tamu-edu-students/ECEN403_Team49/Pics/Pics/rpi.jpg

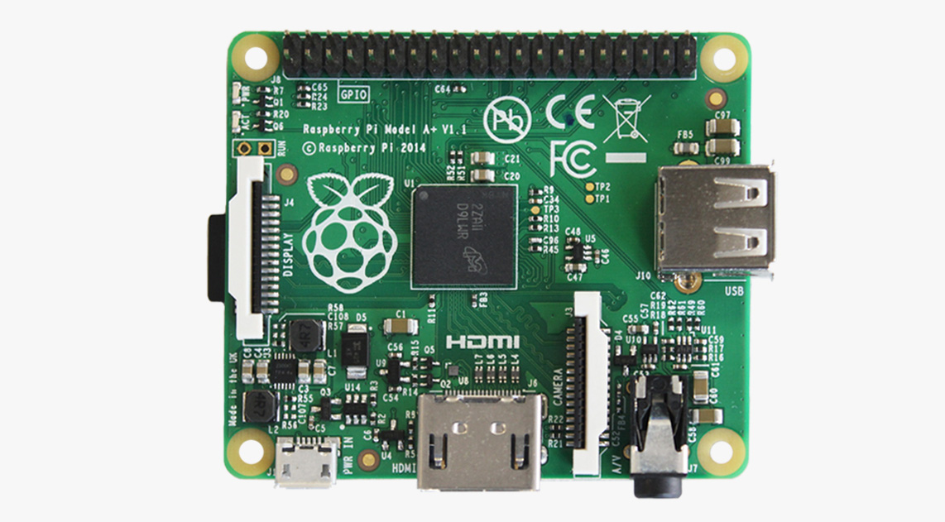
Pics/Pics/rpi.jpg
