tamu-edu-students/ECEN403_Team49/Pics/Pics/fan.PNG

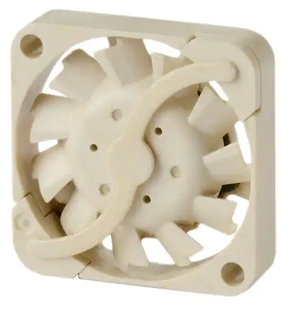
Pics/Pics/fan.PNG
