tamu-edu-students/ECEN403_Team49/README.md

# ECEN403_Team49
ECEN 403 - Team 49: Creating STEM Contents: Solar Power with a Tracking System
