tamu-edu-students/ECEN403_Team49/FinalReport.docx

Creating STEM Contents: Solar Power with a Tracking System

Leo Predanic

George Thuita

Brandon Cenci

Final Report

REVISION – Final

29 April 2023

Table of Contents

Concepts of Operations 1

Functional System Requirements 12

Interface Control Document 29

Execution and Validation 40

Subsystems Report 46

Integration Report 86

Calibrated LWIR Raw Video Data Collection - Gold Standard – Test 1 Revision -
