tamu-edu-students/ECEN403_Team49/Pics/Pics/report_pres_images.pptx

Solar Radiation

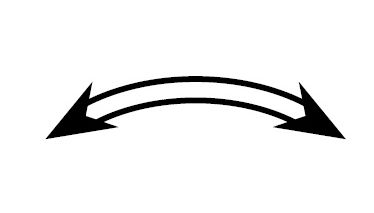
[picture p79: figure]

180° Zenith Angle

Voltage/Current Sense

PCB

Charge Controller

Battery

DC-DC Converter

Switches

Load

GUI & Database


User Interaction

Solar Panel

ADC

MCU

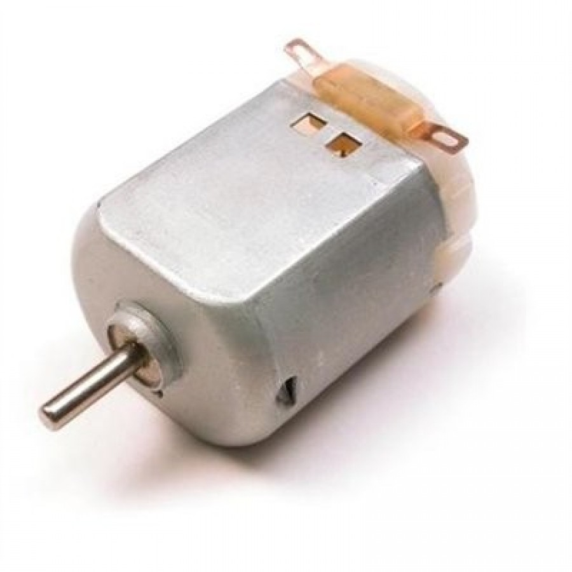
[picture p80: figure]

Motor

Minimum Desk Boundary

## Slide 2

GUI & Database

User Interaction

Voltage/Current Sense

PCB

Charge Controller

Battery

DC-DC Converter

Switches

Load

Solar Panel

ADC

MCU

Motor

Minimum Desk Boundary

## Slide 3

ADC

MCU

Motor

Solar Panel

5.5V
100mA

Charge Controller

3.7V

Battery

2.5V - 3.7V

Buck Boost Converter

3.0V
200mA

Load
