tamu-edu-students/ECEN403_Team49/404 Status Update #4 Team 49.pptx

## ECEN 404 Creating STEM Contents: Solar Power with a Tracking System Status Update #4 Leo Predanic George Thuita Brandon Cenci Sponsor: Dr. Won Jang TA: Souryendu Das


## Executive Summary

Problem statement:
- To create the future of tomorrow, we must invest today - by getting students interested in STEM early
Our Solution:
- Excite K-12 students by creating a portable solar system for demonstration purposes
- Contain digestible figures & animations to describe/track system


## System Flow & Overview


## Execution

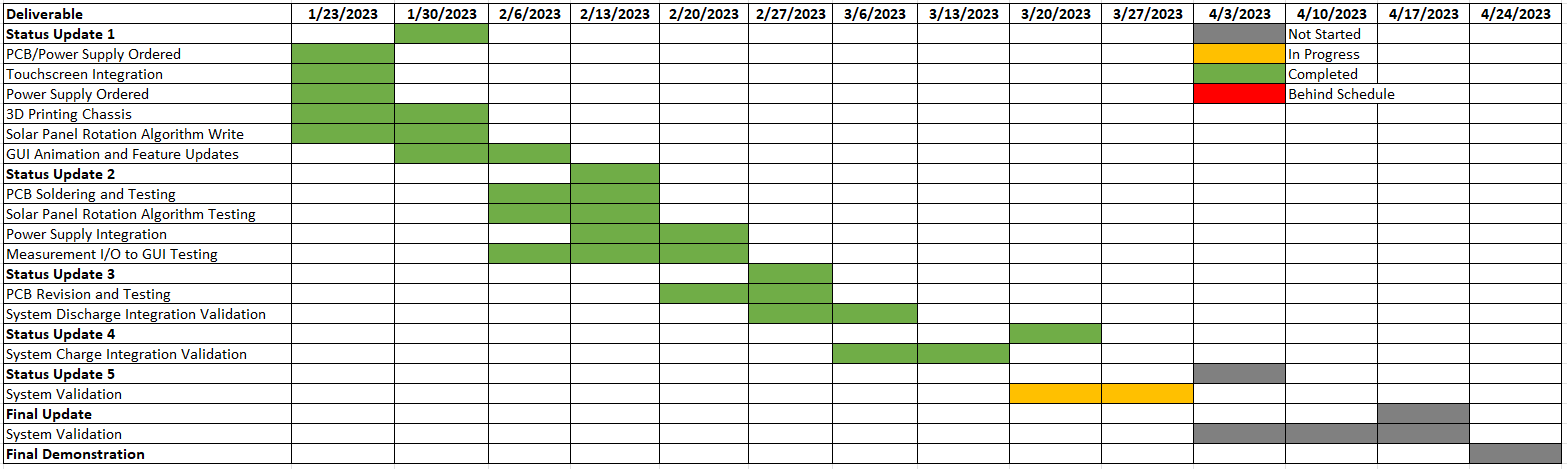
[picture p130: figure]

## Validation

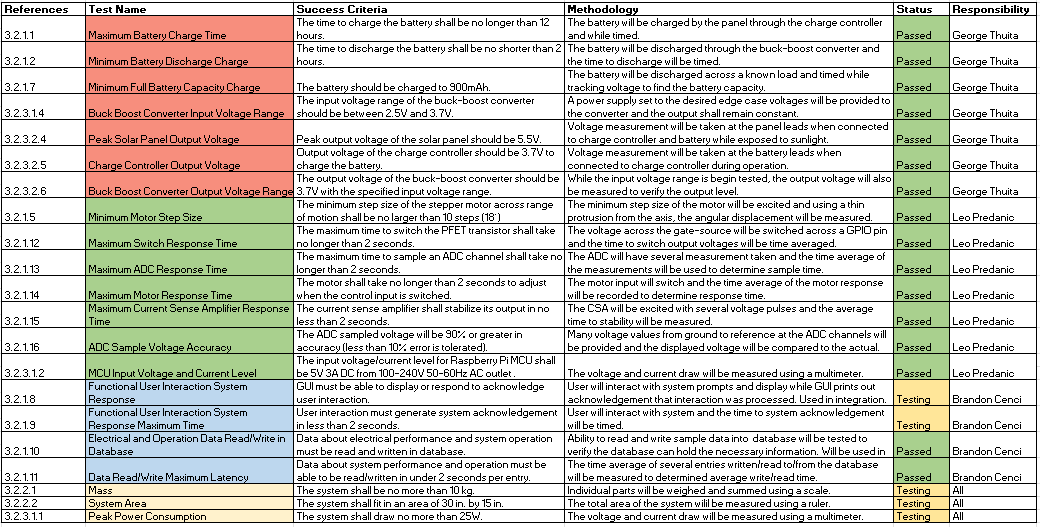
[picture p131: figure]

## Slide 6

Integrated System George Thuita/Leo Predanic/Brandon Cenci

Accomplishments since last presentation 20 hrs each | Ongoing progress/problems and plans until next presentation
-Solar charging issues fixed -System can now solar charge (additional wired charging feature) -Validation on charge side operation -GUI updates and finalization -User control of motor and solar charging mode rotation algorithm -Validation of graphing from internal database -Addition of failsafes to ensure proper user operation | -Solar panel chassis adjustments -Preliminary complete system test -Final validation marks -Additional improvements

## Slide 7

Integrated System (2) George Thuita/Leo Predanic/Brandon Cenci


Discharge Against Time Test Load
Roughly Constant Current across Battery Voltage


Wired Charge Time: ~1 hr (Full Overcharge - 4.2V)
Solar Charge Time: 8-9 hrs (Nominal Voltage - 3.7V)
Discharge Time: ~2.5 hrs (System Load)
Capacity: ~880mAh (Full Overcharge)

## Slide 8

Integrated System (3) George Thuita/Leo Predanic/Brandon Cenci

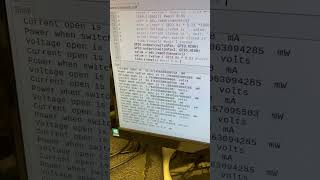
[picture p132: figure]

Solar Panel Integration Test

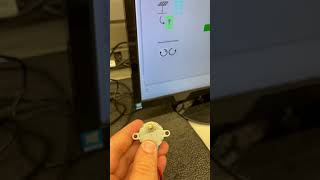
[picture p133: figure]

Motor Manual Control

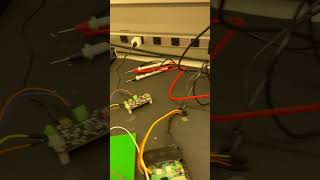
[picture p134: figure]

Charge Controller Integration test

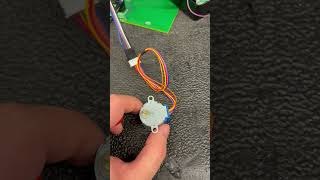
[picture p135: figure]

Motor Timed Control

## Slide 9

Integrated System (4) George Thuita/Leo Predanic/Brandon Cenci

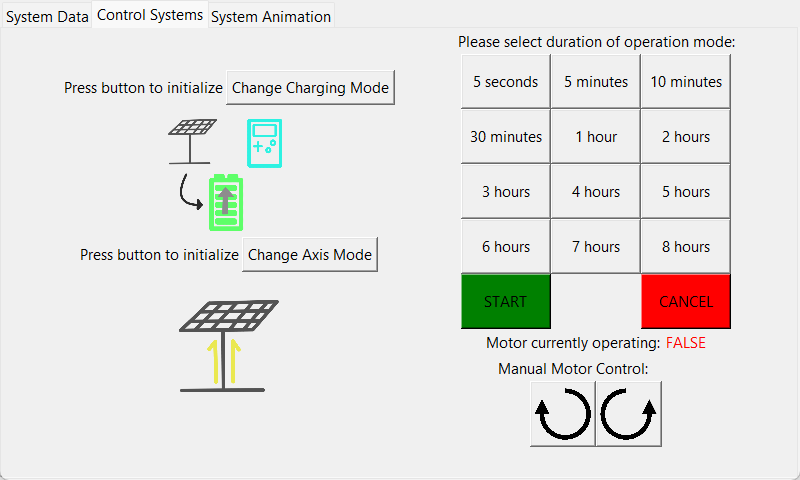
[picture p136: figure]

## Slide 10

Integrated System (5) George Thuita/Leo Predanic/Brandon Cenci

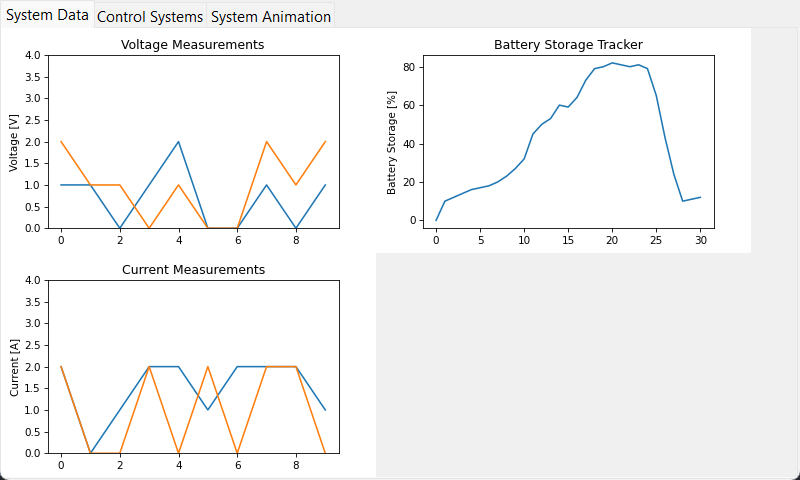
[picture p137: figure]
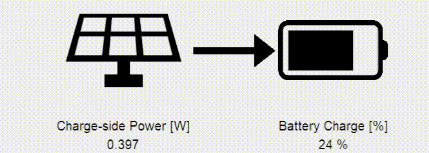
[picture p138: figure]
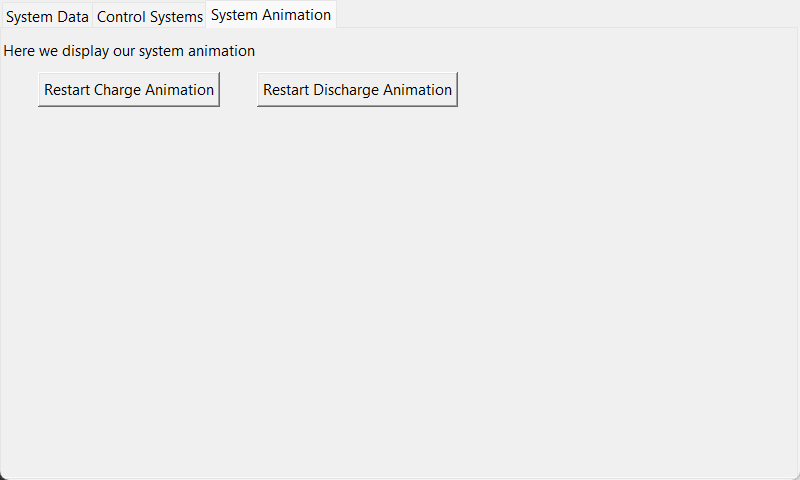
[picture p139: figure]

## Thank You! Questions?
