tamu-edu-students/ECEN403_Team49/403 project update presentation Team 49.pptx

## ECEN 403 Creating STEM Contents: Solar Power with a Tracking System Status Update Presentation Leo Predanic George Thuita Brandon Cenci Sponsor: Dr. Won Jang TA: Sambandh Dhal


## Executive Summary

Problem statement:
- To create the future of tomorrow, we must invest today - by getting students interested in STEM early
Our Solution:
- Excite K-12 students by creating a portable solar system for demonstration purposes
- Contain digestible figures & animations to describe/track system


## System Flow & Overview


## Execution

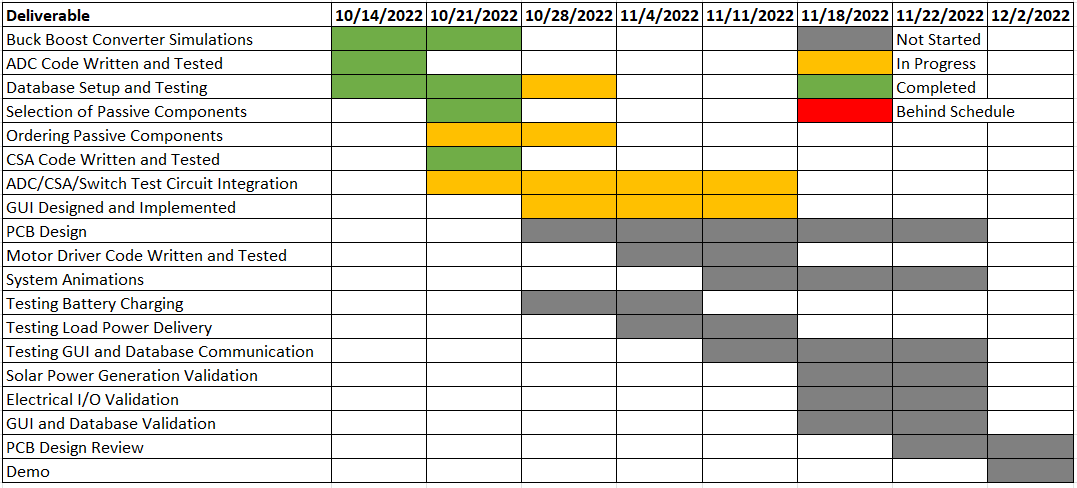
[picture p173: figure]

To be completed by:

## Validation

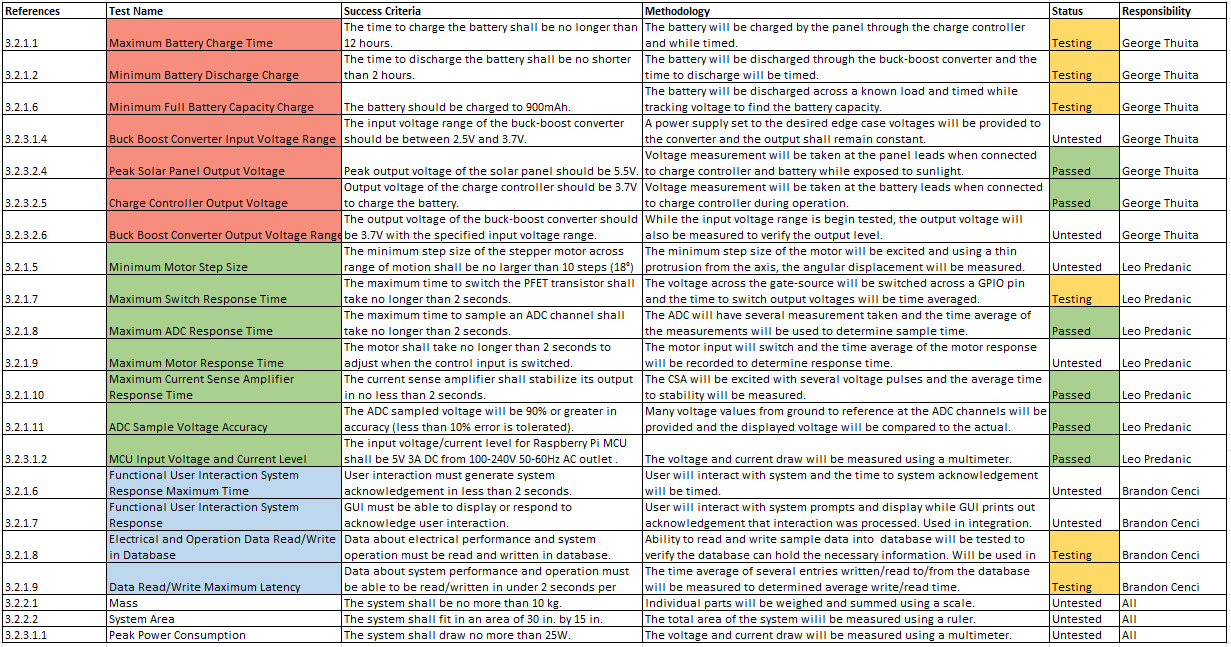
[picture p174: figure]

## Slide 6

Solar Power Generation George Thuita

Accomplishments since the last presentation 20 hrs | Ongoing progress/problems and plans until the next presentation
- Simulated buck-boost converter for edge cases (LTSpice) - Finalized passive components/load and are ready for order - Begun PCB Design | - Testing battery charging with charge controller & solar panel - Testing of battery discharge to load - Electrical measurements/calibration - PCB Design Review

Charge Side (η~95%)

Load


Solar Panel

5.5V
100mA


Charge Controller

3.7V
140mA


Battery


~7 Hours Charge Time


## Slide 7

Solar Power Generation (2) George Thuita


Discharge Side (η~95%)

2.5V-4.2V

3.7V
200mA

1.22V

Load

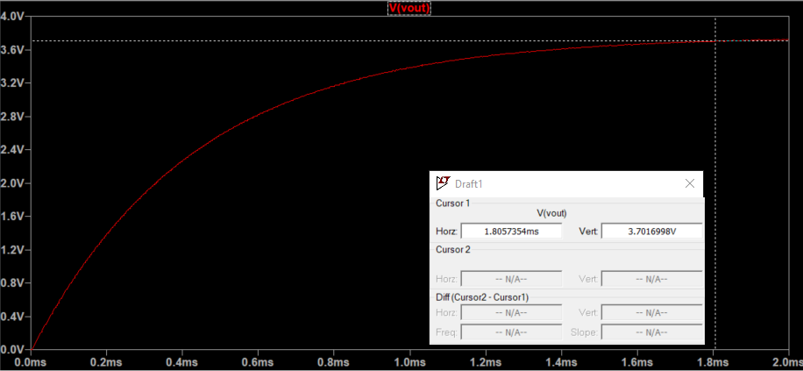
[picture p175: figure]

## Slide 8

Electrical I/O Leo Predanic

Accomplishments since the last presentation 25 hrs | Ongoing progress/problems and plans until the next presentation
- ADC code completed & tested - CSA code completed & tested - Highly accurate results: 1.89% error between measured (3.36mW) and theoretical (3.42mW) - Begun integrating PFET switches | - PFET doesn’t work as expected, threshold voltage is issue, testing new PFET - Full test circuit implementation - Code & testbench for motor driver - Electrical measurements/calibration


*Not indicative of integrated system currents


## Slide 9

GUI and Database Brandon Cenci

Accomplishments since the last presentation 20 hrs | Ongoing progress/problems and plans until the next presentation
-Chose circuit parameters to be read -Created operational database via Pandas -Validated database calculation capabilities -Finalized touch-screen as interface method | -Create and validate GUI outline -Implement graphs and animations in GUI -Ensure proper communication between GUI and database

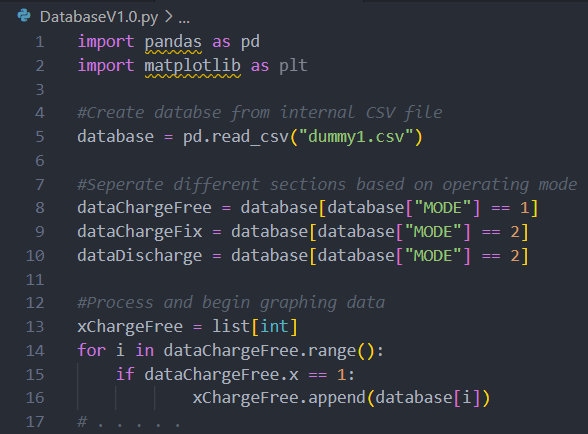
[picture p176: figure]
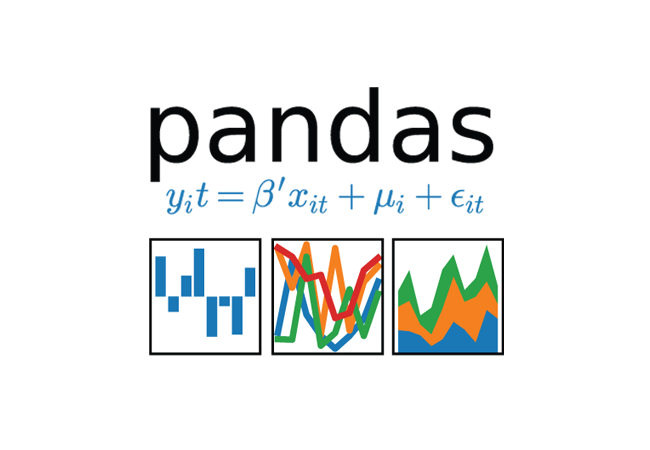
[picture p177: figure]
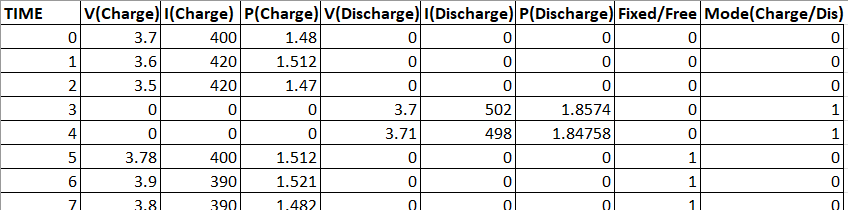
[picture p178: figure]

## Slide 10

GUI and Database (2) Brandon Cenci

Data and Infographics

Circuit/System Animation

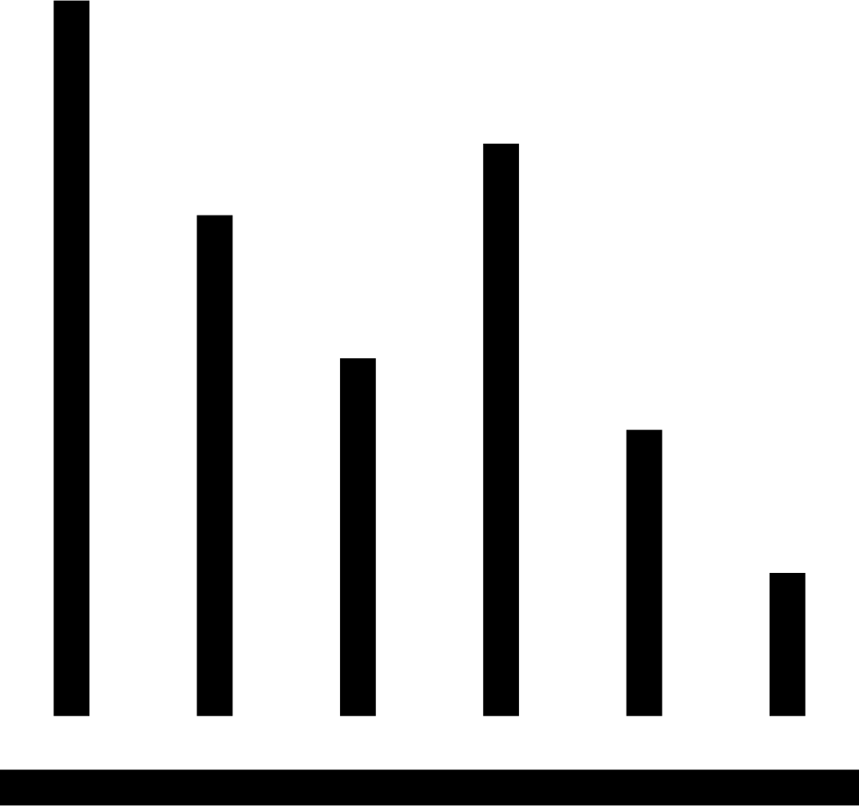
[picture p179: figure]
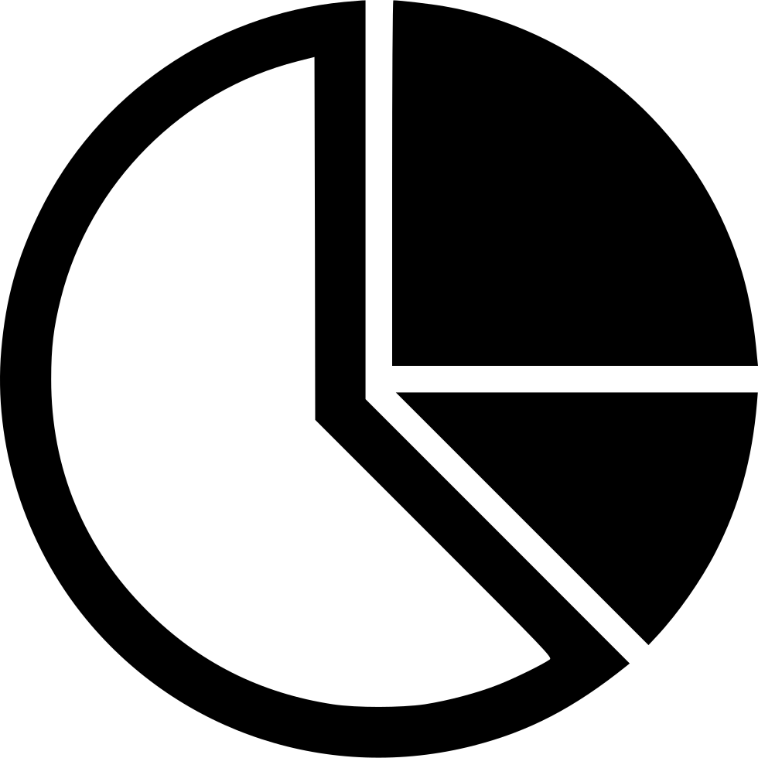
[picture p180: figure]

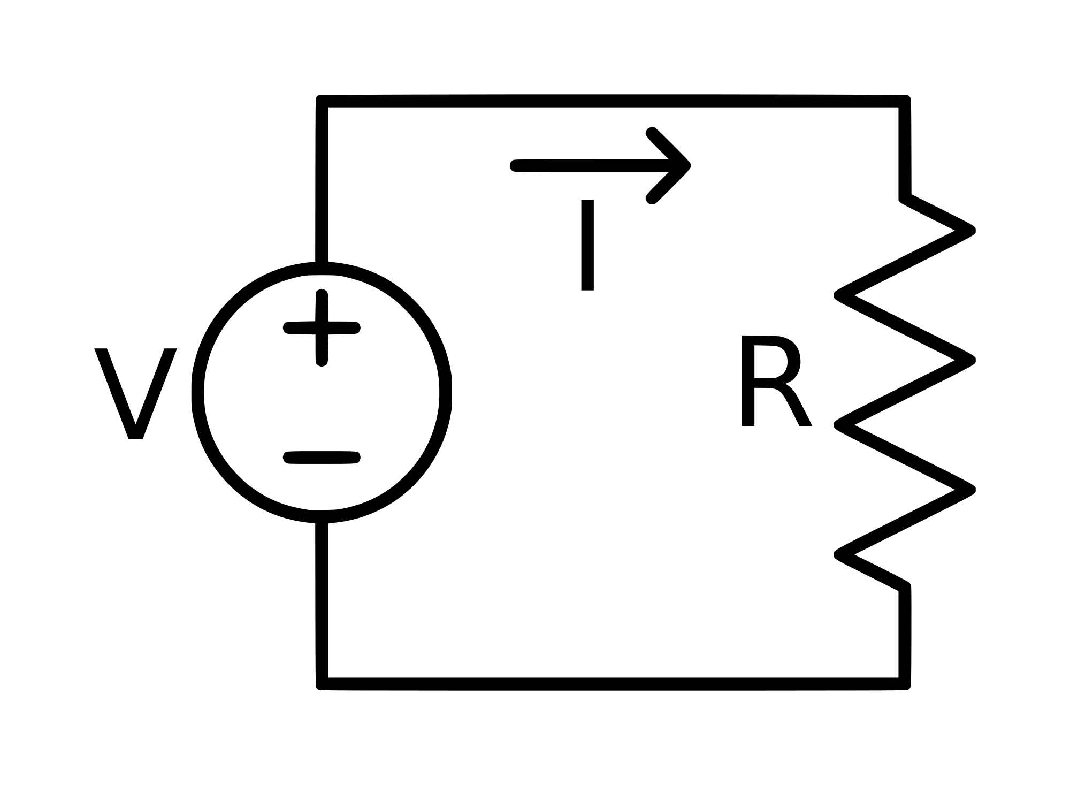
[picture p181: figure]

Control Functionality


## Questions?
