tamu-edu-students/ECEN403_Team49/Charts-Images/flow_chart_9_20_2022.pdf

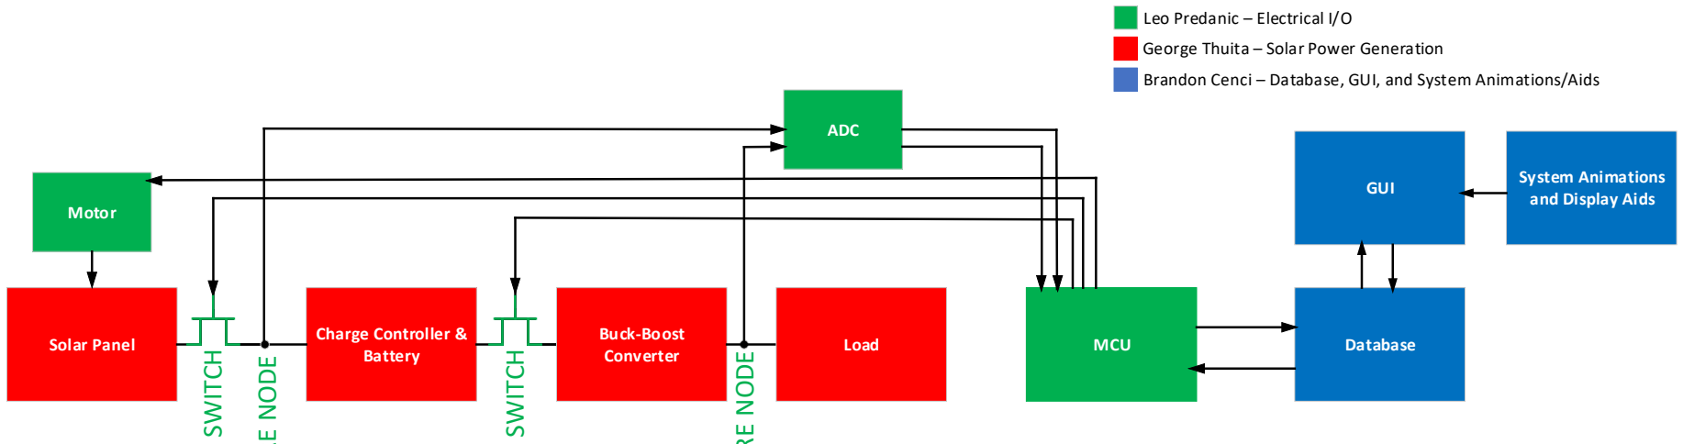
[picture p195: figure]
Solar Panel; Motor; Charge Controller & Battery; SWITCH; Buck-Boost; Converter; Load; MCU; Database; GUI; ADC; System Animations and Display Aids; Leo Predanic – Electrical I/O; George Thuita – Solar Power Generation

## MEASURE NODE

## MEASURE NODE

Brandon Cenci – Database, GUI, and System Animations/Aids
