tamu-edu-students/ECEN403_Team49/exec_valid_excel_finalreport.xlsx

Sheet: Execution403
Deliverable | 2022-10-14 | 2022-10-21 | 2022-10-28 | 2022-11-04 | 2022-11-11 | 2022-11-18 | 2022-11-22 | 2022-12-02
Buck Boost Converter Simulations |  |  |  |  |  |  | Not Started
ADC Code Written and Tested |  |  |  |  |  |  | In Progress
Database Setup and Testing |  |  |  |  |  |  | Completed
Selection of Passive Components |  |  |  |  |  |  | Behind Schedule
Ordering Passive Components
CSA Code Written and Tested
ADC/CSA/Switch Test Circuit Integration
GUI Designed and Implemented
PCB Design
Motor Driver Code Written and Tested
System Animations
Testing Battery Charging
Testing Load Power Delivery
Testing GUI and Database Communication
Solar Power Generation Validation
Electrical I/O Validation
GUI and Database Validation
PCB Design Review
Demo

Sheet: Execution404
Deliverable | 2023-01-23 | 2023-01-30 | 2023-02-06 | 2023-02-13 | 2023-02-20 | 2023-02-27 | 2023-03-06 | 2023-03-13 | 2023-03-20 | 2023-03-27 | 2023-04-03 | 2023-04-10 | 2023-04-17 | 2023-04-24
Status Update 1 |  |  |  |  |  |  |  |  |  |  |  | Not Started
PCB Ordered |  |  |  |  |  |  |  |  |  |  |  | In Progress
Touchscreen Integration |  |  |  |  |  |  |  |  |  |  |  | Completed
Power Supply Ordered |  |  |  |  |  |  |  |  |  |  |  | Behind Schedule
3D Printing Chassis
Solar Panel Rotation Algorithm Write
GUI Animation and Feature Updates
Status Update 2
PCB Soldering and Testing
Solar Panel Rotation Algorithm Testing
Power Supply Integration
Measurement I/O to GUI Testing
Status Update 3
PCB Revision and Testing
System Charge Integration Testing
Status Update 4
System Discharge Integration Testing
Status Update 5
System Validation
Final Update
System Validation
Final Demonstration

Sheet: Validation
References | Test Name | Success Criteria | Methodology | Status | Responsibility
3.2.1.1 | Maximum Battery Charge Time | The time to charge the battery shall be no longer than 12 hours. | The battery will be charged by the panel through the charge controller and while timed. | Untested | George Thuita
3.2.1.2 | Minimum Battery Discharge Charge | The time to discharge the battery shall be no shorter than 2 hours. | The battery will be discharged through the buck-boost converter and the time to discharge will be timed. | Untested | George Thuita
3.2.1.7 | Minimum Full Battery Capacity Charge | The battery should be charged to 900mAh. | The battery will be discharged across a known load and timed while tracking voltage to find the battery capacity. | Untested | George Thuita
3.2.3.1.4 | Buck Boost Converter Input Voltage Range | The input voltage range of the buck-boost converter should be between 2.5V and 3.7V. | A power supply set to the desired edge case voltages will be provided to the converter and the output shall remain constant. | Untested | George Thuita
3.2.3.2.4 | Peak Solar Panel Output Voltage | Peak output voltage of the solar panel should be 5.5V. | Voltage measurement will be taken at the panel leads when connected to charge controller and battery while exposed to sunlight. | Untested | George Thuita
3.2.3.2.5 | Charge Controller Output Voltage | Output voltage of the charge controller should be 3.7V to charge the battery. | Voltage measurement will be taken at the battery leads when connected to charge controller during operation. | Untested | George Thuita
3.2.3.2.6 | Buck Boost Converter Output Voltage Range | The output voltage of the buck-boost converter should be 3.7V with the specified input voltage range. | While the input voltage range is begin tested, the output voltage will also be measured to verify the output level. | Untested | George Thuita
3.2.1.5 | Minimum Motor Step Size | The minimum step size of the stepper motor across range of motion shall be no larger than 10 steps (18°) | The minimum step size of the motor will be excited and using a thin protrusion from the axis, the angular displacement will be measured. | Untested | Leo Predanic
3.2.1.12 | Maximum Switch Response Time | The maximum time to switch the PFET transistor shall take no longer than 2 seconds. | The voltage across the gate-source will be switched across a GPIO pin and the time to switch output voltages will be time averaged. | Untested | Leo Predanic
3.2.1.13 | Maximum ADC Response Time | The maximum time to sample an ADC channel shall take no longer than 2 seconds. | The ADC will have several measurement taken and the time average of the measurements will be used to determine sample time. | Untested | Leo Predanic
3.2.1.14 | Maximum Motor Response Time | The motor shall take no longer than 2 seconds to adjust when the control input is switched. | The motor input will switch and the time average of the motor response will be recorded to determine response time. | Untested | Leo Predanic
3.2.1.15 | Maximum Current Sense Amplifier Response Time | The current sense amplifier shall stabilize its output in no less than 2 seconds. | The CSA will be excited with several voltage pulses and the average time to stability will be measured. | Untested | Leo Predanic | Passed
3.2.1.16 | ADC Sample Voltage Accuracy | The ADC sampled voltage will be 90% or greater in accuracy (less than 10% error is tolerated). | Many voltage values from ground to reference at the ADC channels will be provided and the displayed voltage will be compared to the actual. | Untested | Leo Predanic
3.2.3.1.2 | MCU Input Voltage and Current Level | The input voltage/current level for Raspberry Pi MCU shall be 5V 3A DC from 100-240V 50-60Hz AC outlet . | The voltage and current draw will be measured using a multimeter. | Untested | Leo Predanic
3.2.1.8 | Functional User Interaction System Response | GUI must be able to display or respond to acknowledge user interaction. | User will interact with system prompts and display while GUI prints out acknowledgement that interaction was processed. Used in integration. | Untested | Brandon Cenci
3.2.1.9 | Functional User Interaction System Response Maximum Time | User interaction must generate system acknowledgement in less than 2 seconds. | User will interact with system and the time to system acknowledgement will be timed. | Untested | Brandon Cenci
3.2.1.10 | Electrical and Operation Data Read/Write in Database | Data about electrical performance and system operation must be read and written in database. | Ability to read and write sample data into database will be tested to verify the database can hold the necessary information. Will be used in integration. | Untested | Brandon Cenci
3.2.1.11 | Data Read/Write Maximum Latency | Data about system performance and operation must be able to be read/written in under 2 seconds per entry. | The time average of several entries written/read to/from the database will be measured to determined average write/read time. | Untested | Brandon Cenci
3.2.2.1 | Mass | The system shall be no more than 10 kg. | Individual parts will be weighed and summed using a scale. | Untested | All
3.2.2.2 | System Area | The system shall fit in an area of 30 in. by 15 in. | The total area of the system wilil be measured using a ruler. | Untested | All
3.2.3.1.1 | Peak Power Consumption | The system shall draw no more than 25W. | The voltage and current draw will be measured using a multimeter. | Untested | All
