tamu-edu-students/ECEN403_Team49/Charts-Images/2022-11-08-230022_1920x1080_scrot.png

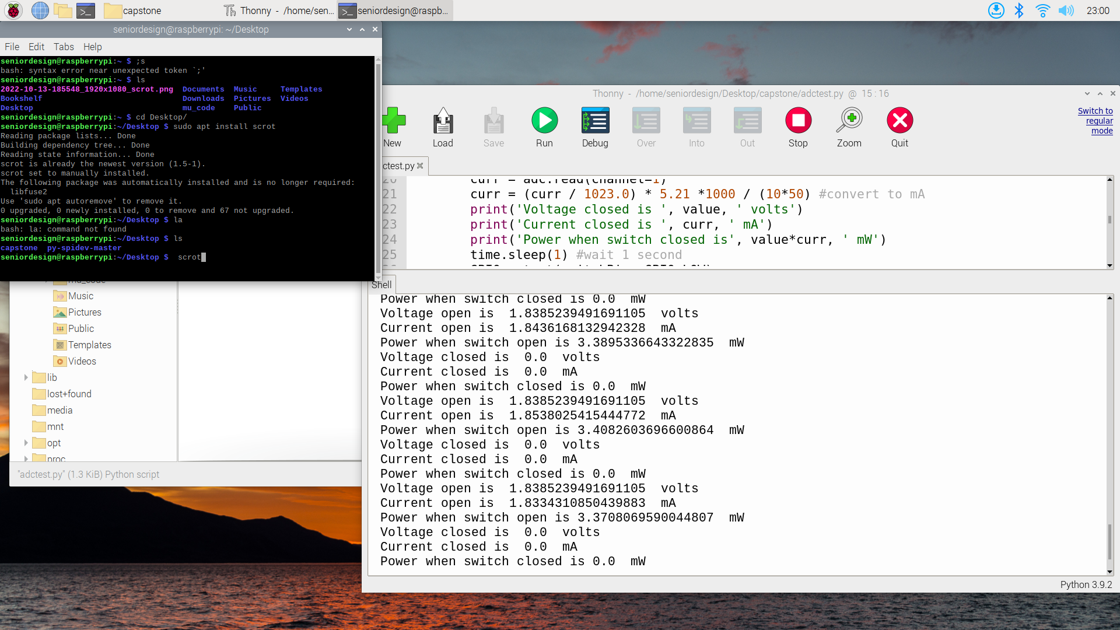
Charts-Images/2022-11-08-230022_1920x1080_scrot.png
