tamu-edu-students/ECEN403_Team49/Charts-Images/concept_imag.PNG

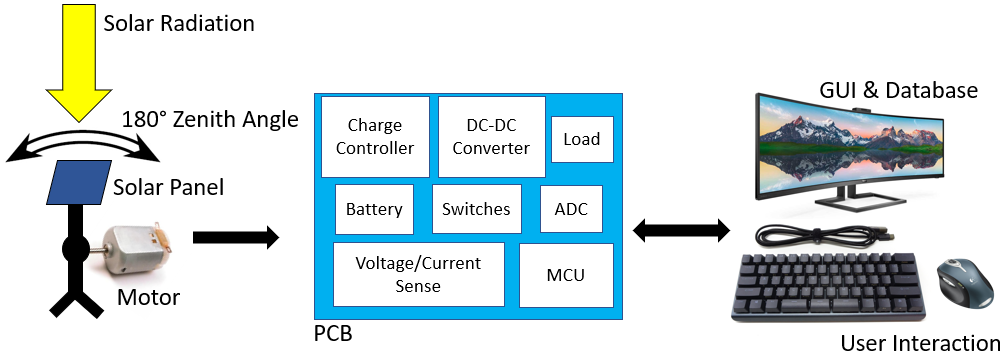
Charts-Images/concept_imag.PNG
