tamu-edu-students/ECEN403_Team49/Charts-Images/flow_9_20_22.PNG

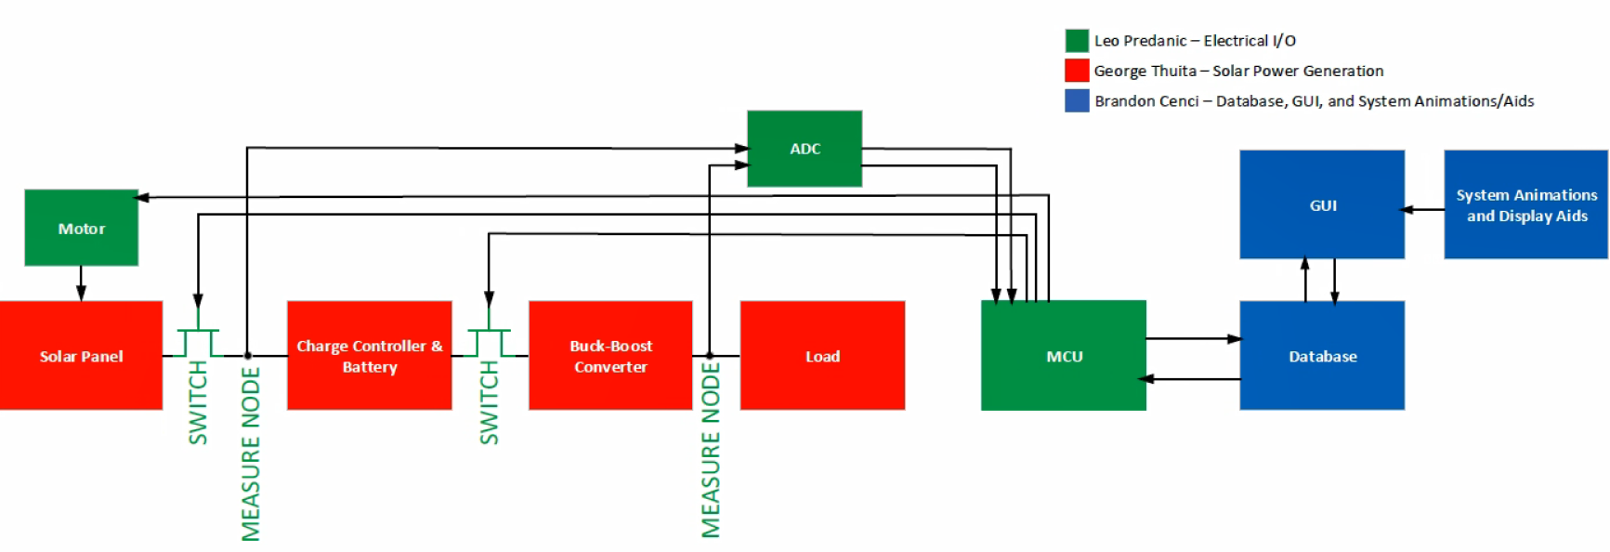
Charts-Images/flow_9_20_22.PNG
