tamu-edu-students/ECEN403_Team49/GUI/ccwarrow.png

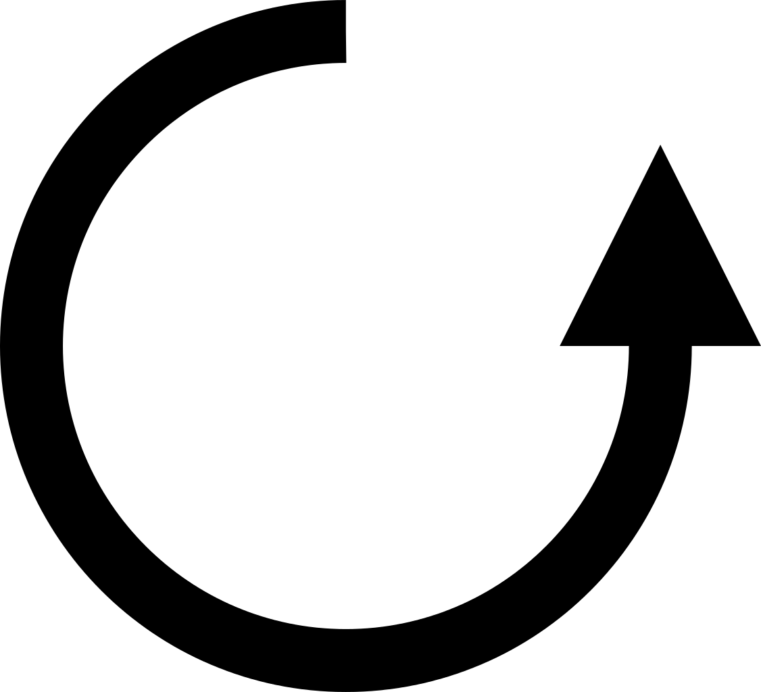
GUI/ccwarrow.png
