tamu-edu-students/ECEN403_Team49/GUI/chargeAnim/ani_charge5.png

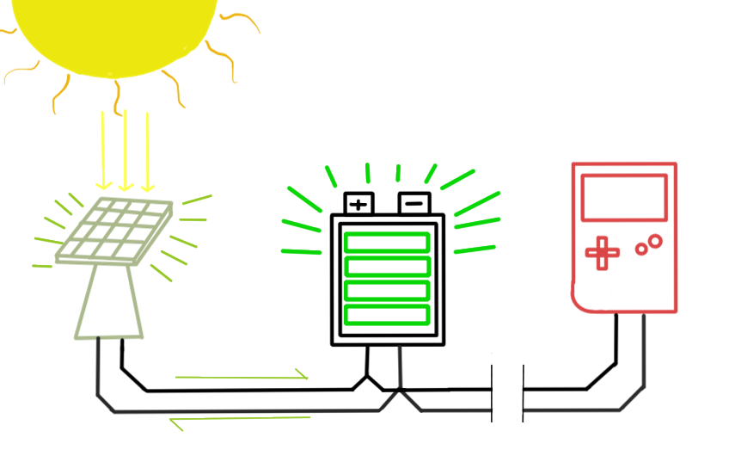
GUI/chargeAnim/ani_charge5.png
