tamu-edu-students/ECEN403_Team49/GUI/chargeAnim/charge3.png

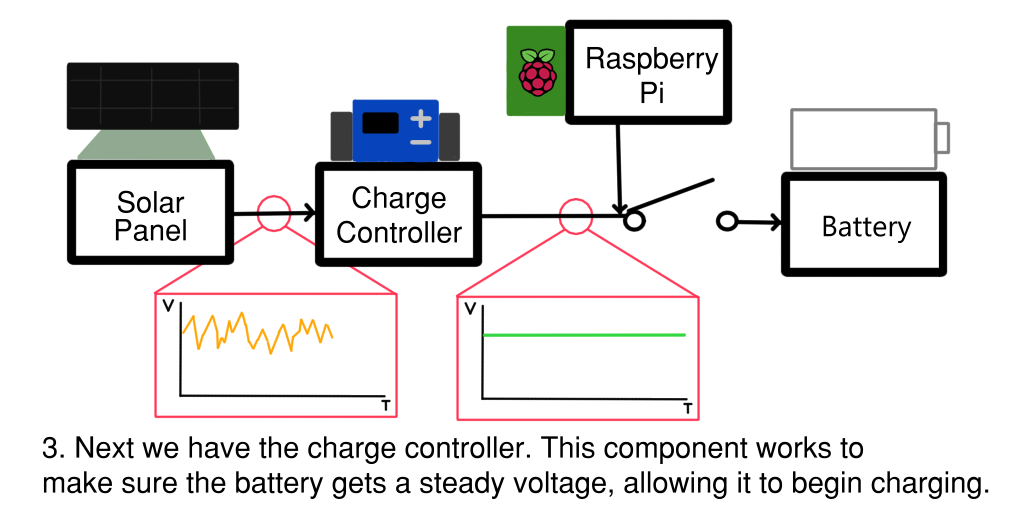
GUI/chargeAnim/charge3.png
