tamu-edu-students/ECEN403_Team49/GUI/chargeAnim/charge4.png

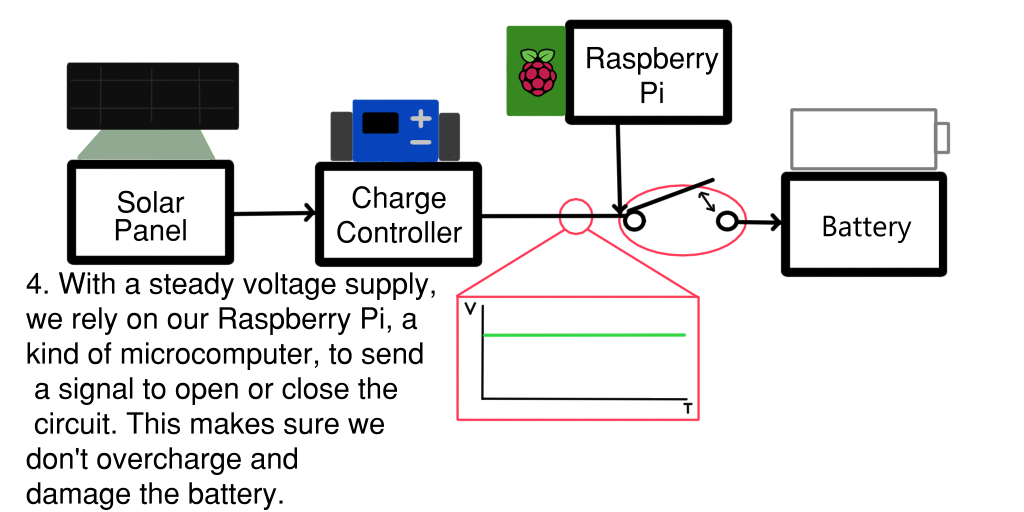
GUI/chargeAnim/charge4.png
