tamu-edu-students/ECEN403_Team49/GUI/chargeAnim/charge5.png

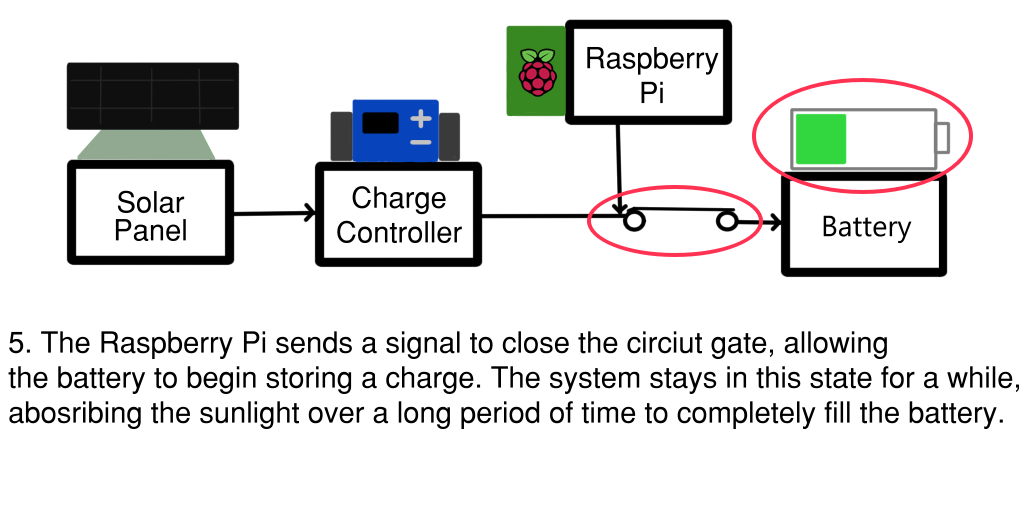
GUI/chargeAnim/charge5.png
