tamu-edu-students/ECEN403_Team49/GUI/chargeAnim/charge6.png

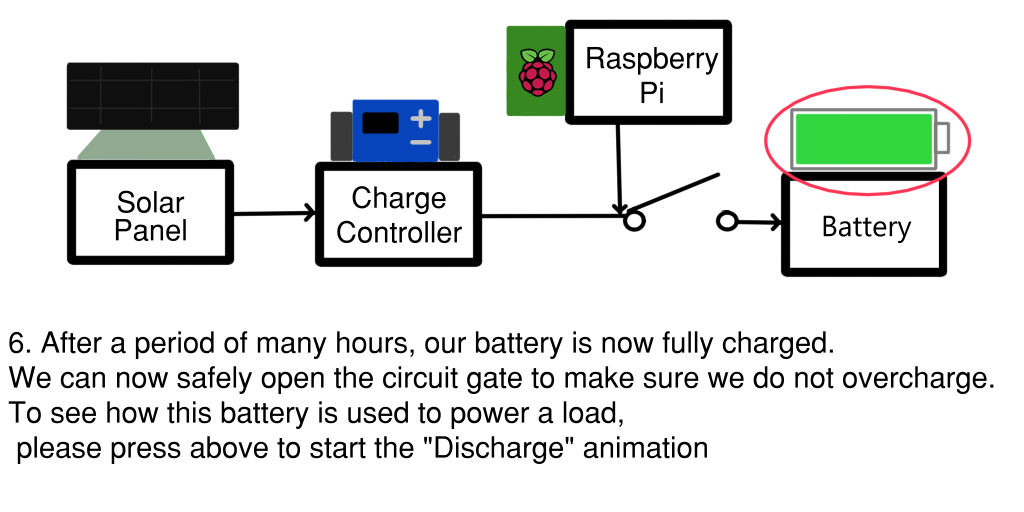
GUI/chargeAnim/charge6.png
