tamu-edu-students/ECEN403_Team49/GUI/dischargeAnim/ani_discharge1.png

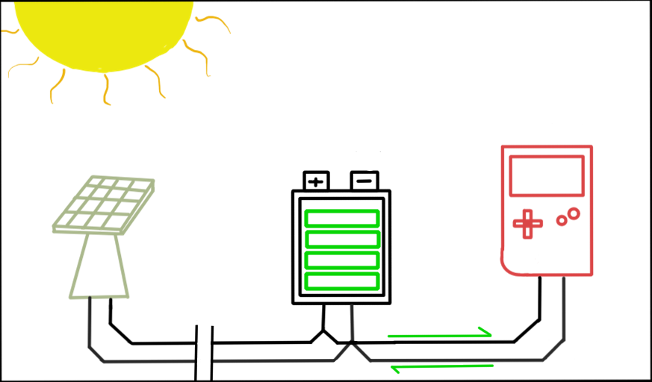
GUI/dischargeAnim/ani_discharge1.png
