tamu-edu-students/ECEN403_Team49/GUI/dischargeAnim/discharge1.png

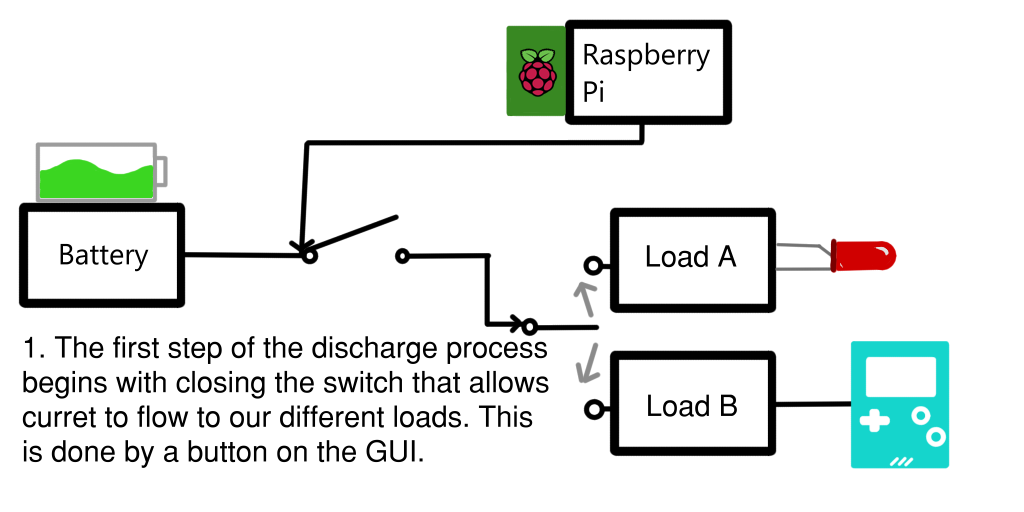
GUI/dischargeAnim/discharge1.png
