tamu-edu-students/ECEN403_Team49/GUI/dischargeAnim/discharge2.png

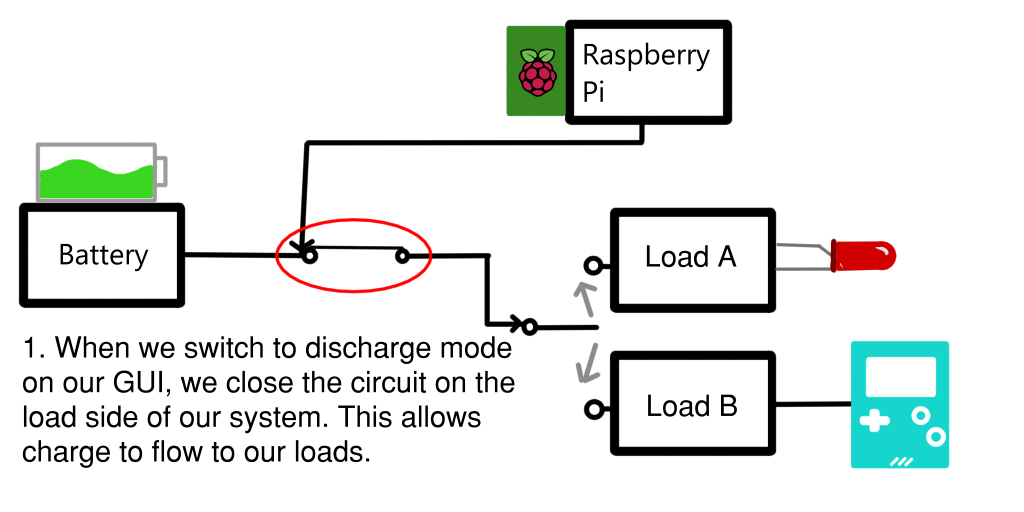
GUI/dischargeAnim/discharge2.png
