tamu-edu-students/ECEN403_Team49/GUI/dischargeAnim/discharge3.png

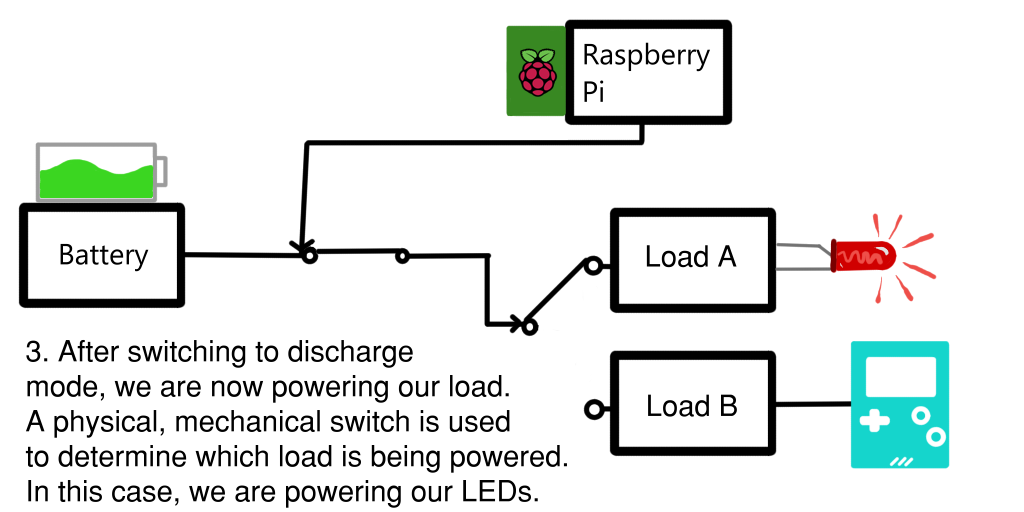
GUI/dischargeAnim/discharge3.png
