tamu-edu-students/ECEN403_Team49/GUI/dischargeAnim/discharge4.png

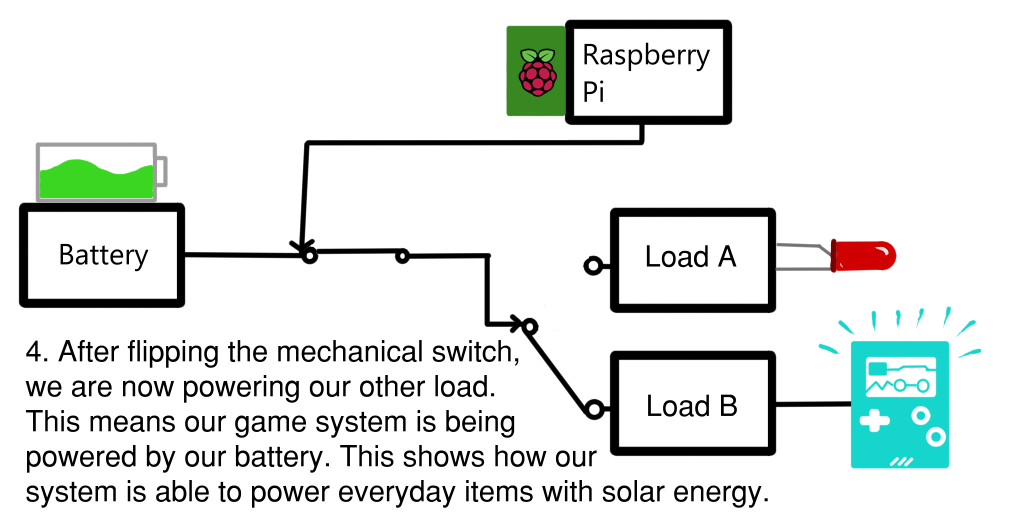
GUI/dischargeAnim/discharge4.png
