tamu-edu-students/ECEN403_Team49/GUI/modeC.png

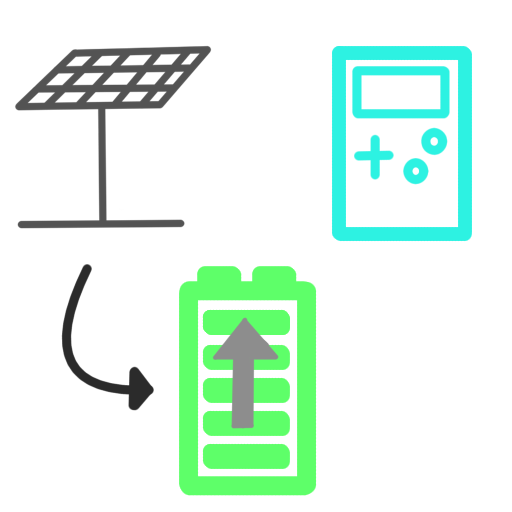
GUI/modeC.png
