tamu-edu-students/ECEN403_Team49/GUI/modeD.png

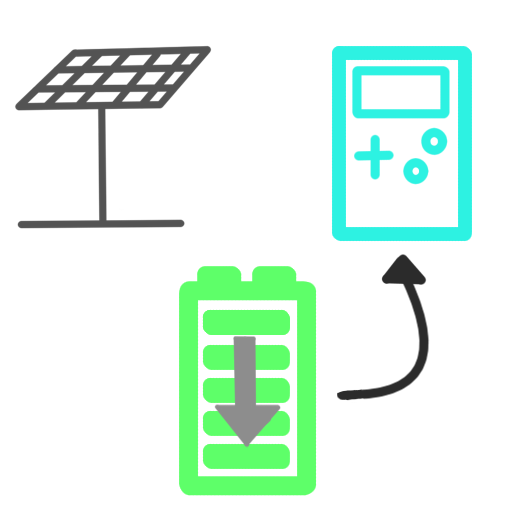
GUI/modeD.png
