tamu-edu-students/ECEN403_Team49/GUI/panel.png

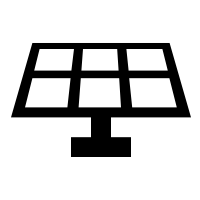
GUI/panel.png
