tamu-edu-students/ECEN403_Team49/GUI/panelFree.png

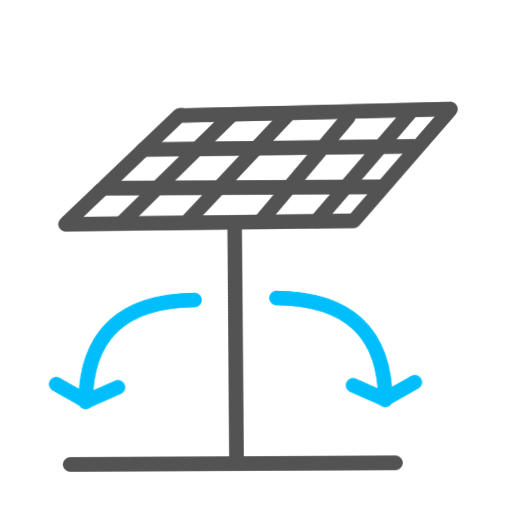
GUI/panelFree.png
