tamu-edu-students/ECEN403_Team49/GUI/pic1.png

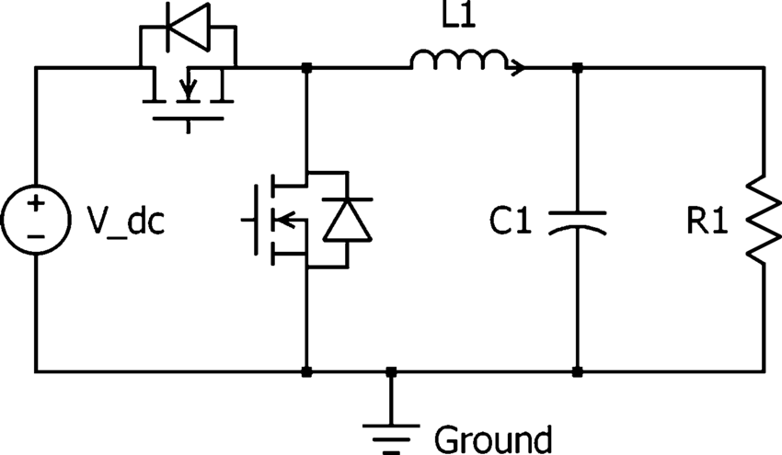
GUI/pic1.png
