tamu-edu-students/ECEN403_Team49/GUI/pic2.gif

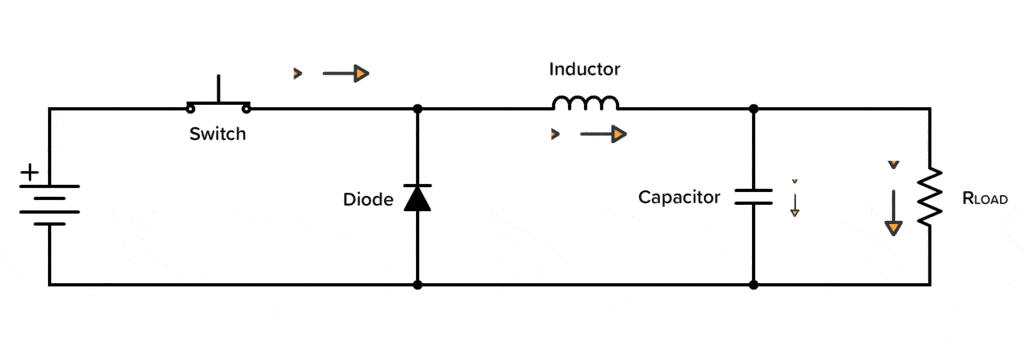
GUI/pic2.gif
