tamu-edu-students/ECEN403_Team49/GUI/Simple_circuit_diagram.gif

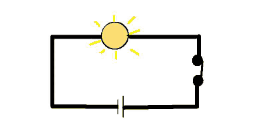
GUI/Simple_circuit_diagram.gif
