tamu-edu-students/ECEN403_Team49/Pics/Pics/brandon.PNG

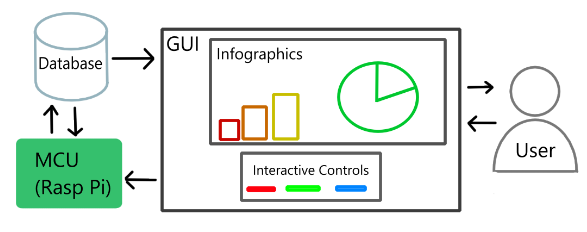
Pics/Pics/brandon.PNG
