tamu-edu-students/ECEN403_Team49/Pics/Pics/tech-color_keyboard-mouse-512.webp

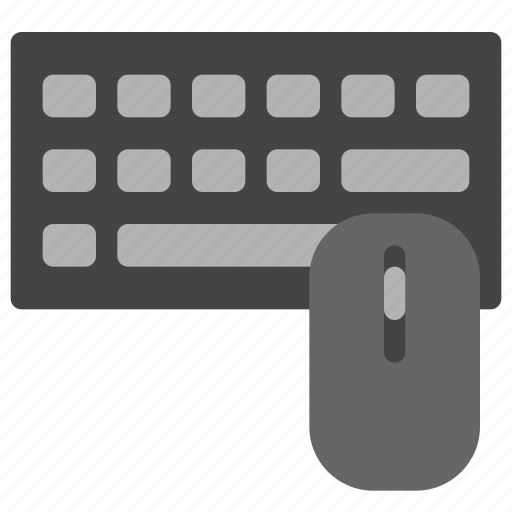
Pics/Pics/tech-color_keyboard-mouse-512.webp
