tamu-edu-students/ECEN403_Team49/Parts Lists.xlsx

Sheet: Suggested
Name | Link | Quantity | Price Per Unit | Description
Solar Panel | https://www.digikey.com/en/products/detail/seeed-technology-co-ltd/313070004/5488049 | 3 | $6.07
Battery 1 | https://www.digikey.com/en/products/detail/b-b-battery/BP1-2-6-T1/653321 | tba | $14.74
Battery 2 | https://www.digikey.com/en/products/detail/globtek-inc/BL0750F5030481S1PCMC/10187617 | tba | $11.07
Battery 3 | https://www.digikey.com/en/products/detail/batteryguy/BGN800-3DWP-41REC/12702777 | tba | $15.03
Motor 1(DC) | https://www.digikey.com/en/products/detail/johnson-motor/NF103G-301/12719598 | tba | $7.66
Motor 2(DC) | https://www.digikey.com/en/products/detail/johnson-motor/HC385MG-304/12719602 | tba | $10.07
Motor 3(DC) | https://www.digikey.com/en/products/detail/johnson-motor/HC385G-302/12723725 | tba | $6.72
Buck Boost Converter | https://www.digikey.com/en/products/detail/monolithic-power-systems-inc/MP28164GD-Z/7361608 | tba | $3.65
Voltage regulator 1 | https://www.digikey.com/en/products/detail/ablic-inc/S-1313D23H-A4T1U3/14664162 | tba | $1.66
Voltage Regulator 2 | https://www.digikey.com/en/products/detail/ablic-inc/S-1313A17-A4T2U3/14664161 | tba | $0.94
Voltage Regulator 3 | https://www.digikey.com/en/products/detail/ablic-inc/S-1313A25-A4T2U3/14664157 | tba | $0.94
Voltage Regulator 4 | https://www.digikey.com/en/products/detail/ablic-inc/S-1313D30-A4T2U3/14664152 | tba | $0.94
Servo 1 | https://www.alliedelec.com/product/nippon-pulse/pje42t-34d14/71949716/?gclsrc=aw.ds&gclsrc=ds&gclsrc=aw.ds | tba | $26.60
Servo 2 | https://hobbyking.com/en_us/hxt900-micro-servo-1-6kg-0-12sec-9-8g.html?wrh_pdp=2&countrycode=US | tba | $3.49
Buck Boost Converter | ADP1073AN Analog Devices Inc. | Integrated Circuits (ICs) | DigiKey Marketplace (https://www.digikey.com/en/products/detail/rochester-electronics-llc/ADP1073AN/12112253)
Servo 3(Digikey) | https://www.digikey.com/en/products/detail/adafruit-industries-llc/4326/10419470 | tba | 5.95
Servo 4(Digikey) | https://www.digikey.com/en/products/detail/adafruit-industries-llc/2442/5774227 |  | $7.50
More battery charge | LP523450JU+PCM+2 WIRES 70MM Jauch Quartz | Battery Products | DigiKey (https://www.digikey.com/en/products/detail/jauch-quartz/LP523450JU-PCM-2-WIRES-70MM/9560988)
Buck Boost Converter (LTC3440EMS#PBF) | LTC3440 Datasheet and Product Info | Analog Devices (https://www.analog.com/en/products/ltc3440.html) | 3
Motor | https://hobbyking.com/en_us/hxt900-micro-servo-1-6kg-0-12sec-9-8g.html?wrh_pdp=2&countrycode=US | 2 | $3.49 | $6.98
Battery | BL0750F5030481S1PCMC GlobTek, Inc. | Battery Products | DigiKey (https://www.digikey.com/en/products/detail/globtek-inc/BL0750F5030481S1PCMC/10187617) | 2 | $11.07 | $22.14
Stepper Motor | 108990003 Seeed Technology Co., Ltd | Motors, Solenoids, Driver Boards/Modules | DigiKey (https://www.digikey.com/en/products/detail/seeed-technology-co-ltd/108990003/5487797)
Switch fet | SFS9614 Fairchild Semiconductor | Discrete Semiconductor Products | DigiKey Marketplace (https://www.digikey.com/en/products/detail/rochester-electronics-llc/SFS9614/12128110)
switch fet (rdson=0.5Ohm) | SFS9640 Fairchild Semiconductor | Discrete Semiconductor Products | DigiKey Marketplace (https://www.digikey.com/en/products/detail/rochester-electronics-llc/SFS9640/12127473)
Motor 2(160mA) | https://www.digikey.com/en/products/detail/seeed-technology-co-ltd/114090050/10385087
Motor 3(120mA) | https://www.digikey.com/en/products/detail/osepp-electronics-ltd/LS-00024/11198647
Motor 4(100mA) (this is best) | https://www.digikey.com/en/products/detail/osepp-electronics-ltd/LS-00026/11198625
1.5nF Capacitor | https://www.digikey.com/en/products/detail/cornell-dubilier-electronics-cde/CDV19FF152JO3F/1918726 |  | $6.04
60.4K Ressitor(0.6W) | https://www.digikey.com/en/products/detail/vishay-beyschlag-draloric-bc-components/MRS25000C6042FCT00/5064566 |  | $0.29
200k Resistor | https://www.digikey.com/en/products/detail/vishay-beyschlag-draloric-bc-components/PR01000102003JR500/596008 |  | $0.03
60.4K resistor(1W) | https://www.mouser.com/ProductDetail/Vishay-Dale/CPF160K400BEB14 |  | $2.05
15K Resistor(1W) | https://www.digikey.com/en/products/detail/te-connectivity-passive-product/RR01J15KTB/2384862 |  | $0.32
400k Resistor(1W) | https://www.mouser.com/ProductDetail/Vishay-Dale/CMF60400K00BHBF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 |  | $1.11
6K Resistor(5W) | ALSR056K000JE12 Vishay Dale | Resistors | DigiKey (https://www.digikey.com/en/products/detail/vishay-dale/ALSR056K000JE12/257453) |  | $0.75
10uH inductor | CTHFW2918F-100M Central Technologies | Inductors, Coils, Chokes | DigiKey Marketplace (https://www.digikey.com/en/products/detail/central-technologies/CTHFW2918F-100M/16039210)

Sheet: To Order
Name | Link | Quantity | Price Per Unit | Total Part Price
Solar Panel | https://www.digikey.com/en/products/detail/seeed-technology-co-ltd/313070004/5488049 | 3 | $6.07 | $18.21
ADC (MCP3008-I/P PDIP Packaged) | MCP3008-I/P Microchip Technology | Integrated Circuits (ICs) | DigiKey (https://www.digikey.com/en/products/detail/microchip-technology/MCP3008-I-P/319422) | 5 | $2.97 | $14.85
Current Sense Amplifier | MAX49921FATA/VY+ Maxim Integrated | Mouser (https://www.mouser.com/ProductDetail/Maxim-Integrated/MAX49921FATA-VY%2b?qs=hd1VzrDQEGjSbzzCHfSS9g%3D%3D) | 4 | $2.62 | $10.48
Battery | LP523450JU+PCM+2 WIRES 70MM Jauch Quartz | Battery Products | DigiKey (https://www.digikey.com/en/products/detail/jauch-quartz/LP523450JU-PCM-2-WIRES-70MM/9560988) | 2 | $11.30 | $22.60
DC Load (Fan) | UF3F3-700B Sunon Fans | Fans, Thermal Management | DigiKey (https://www.digikey.com/en/products/detail/sunon-fans/UF3F3-700B/10056769) | 1 | $22.28 | $22.28
Solar MPPT Charger | Amazon.com : DFROBOT 900mA MPPT Solar Panel Controller - Solar Power Manager Module for 5V Solar Panel - Support Solar and USB Charging : Patio, Lawn & Garden (https://www.amazon.com/DFROBOT-900mA-Solar-Panel-Controller/dp/B07MML4YJV) | 1 | $13.90 | $13.90
Current Sense Resistor | SR55L000FE66 Vishay Dale | Resistors | DigiKey (https://www.digikey.com/en/products/detail/vishay-dale/SR55L000FE66/7560317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) | 5 | $1.22 | $6.10
Stepper Motor Driver | STSPIN220 STMicroelectronics | Integrated Circuits (ICs) | DigiKey (https://www.digikey.com/en/products/detail/stmicroelectronics/STSPIN220/6137574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) | 3 | $2.29 | $6.87 | 2022-10-07
Switching Fet | FQPF7P20 onsemi | Discrete Semiconductor Products | DigiKey (https://www.digikey.com/en/products/detail/onsemi/FQPF7P20/1055236) | 10 | $1.67 | $16.70
RPi Touch Screen | Amazon.com: Raspberry Pi 7" Touch Screen Display : Electronics (https://www.amazon.com/Raspberry-Pi-7-Touchscreen-Display/dp/B0153R2A9I) | 1 | $64.99 | $64.99
Adapter Board for Motor Driver (IPC0006) | IPC0006 Chip Quik Inc. | Prototyping, Fabrication Products | DigiKey (https://www.digikey.com/en/products/detail/chip-quik-inc./IPC0006/5014791) | 3 | $7.89 | $23.67
Stepper Motor | Amazon.com: 2pcs 3D Printer NEMA17 Stepper Motor Kit 1.0A 33N.cm (47oz.in) 4-Lead Wire with 1m Cable (2LL3401MOTOR) : Industrial & Scientific (https://www.amazon.com/Printer-NEMA17-Stepper-33N-cm-2LL3401MOTOR/dp/B09NVL75DS) | 1 | $16.88 | $16.88
1.5nF Capacitor | https://www.digikey.com/en/products/detail/cornell-dubilier-electronics-cde/CDV19FF152JO3F/1918726 |  | Total | $237.53
60.4K Ressitor(0.6W) | https://www.digikey.com/en/products/detail/vishay-beyschlag-draloric-bc-components/MRS25000C6042FCT00/5064566
200k Resistor | https://www.digikey.com/en/products/detail/vishay-beyschlag-draloric-bc-components/PR01000102003JR500/596008
60.4K resistor(1W) | https://www.mouser.com/ProductDetail/Vishay-Dale/CPF160K400BEB14
15K Resistor(1W) | https://www.digikey.com/en/products/detail/te-connectivity-passive-product/RR01J15KTB/2384862
400k Resistor(1W) | https://www.mouser.com/ProductDetail/Vishay-Dale/CMF60400K00BHBF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
6K Resistor(5W) | ALSR056K000JE12 Vishay Dale | Resistors | DigiKey (https://www.digikey.com/en/products/detail/vishay-dale/ALSR056K000JE12/257453)
10uH inductor | CTHFW2918F-100M Central Technologies | Inductors, Coils, Chokes | DigiKey Marketplace (https://www.digikey.com/en/products/detail/central-technologies/CTHFW2918F-100M/16039210)
2023-01-23
Wire to board Contact(Green) | https://www.digikey.com/en/products/detail/phoenix-contact/1729128/260615 | 5 | $1.32 | $6.60
Switch | https://www.mouser.com/ProductDetail/TE-Connectivity-Alcoswitch/A101SYCB04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 | 1 | $5.39 | $5.39
16 Pin IC Socket | https://www.digikey.com/en/products/detail/on-shore-technology-inc/ED16DT/4147596 | 2 | $0.26 | $0.52
PCB | 4pcb.com | 1 | $30 | $30
 |  | Total | $280.04
2023-01-25
Power Adapter 5V 30W | GST60A05-P1J MEAN WELL USA Inc. | Power Supplies - External/Internal (Off-Board) | DigiKey (https://www.digikey.com/en/products/detail/mean-well-usa-inc/GST60A05-P1J/7703709) | 1 | $22.04
 |  | Total = | $302.08
