tamu-edu-students/ECEN403_Team49/Pics/Pics/Exec_Valid_testslide.PNG

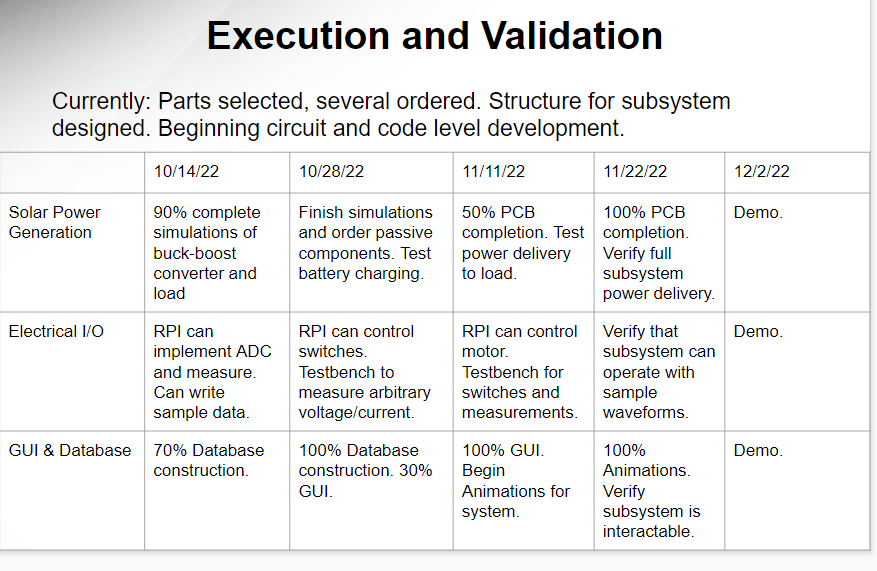
Pics/Pics/Exec_Valid_testslide.PNG
