tamu-edu-students/ECEN403_Team49/Charts-Images/adc_csa_testckt.pdf

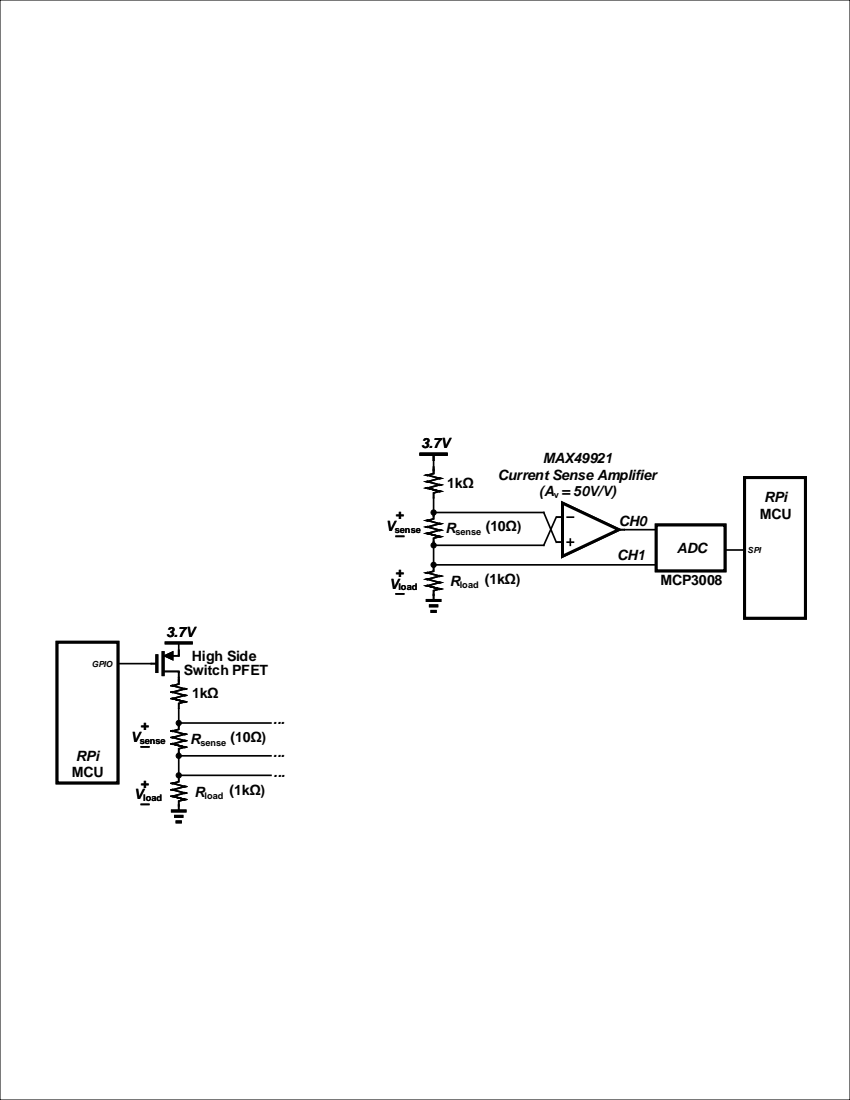
[picture p229: page 1]
R (10Ω) sense; Rload (1kΩ); MAX49921; Vsense; Vload; ADC; RPi MCU; SPI; GPIO; High Side; Switch PFET; MCP3008

Current Sense Amplifier
