tamu-edu-students/ECEN403_Team49/Sim Files/converter_92622.asc

C1: cap; 4.7µ
C2: cap; 4.7µ
C3: cap; 1.5n
L2: ind; 4.7µ
R1: res; 292k
R2: res; 200k
R3: res; 15k
R4: res; 60.4k
R5: res; 83
U1: LTC3440
V1: voltage; 3
Named nets: Vout, 0
.tran 1.2m
