tamu-edu-students/ECEN403_Team49/(list of files, drawings)

Other design files:
PCB Design Files/11-7-22/ADC converter/ADC converter.PcbLib
PCB Design Files/11-7-22/ADC converter/ADC converter.SchLib
PCB Design Files/11-7-22/Buck Boost Converter/Buck Boost Converter.PcbLib
PCB Design Files/11-7-22/Buck Boost Converter/Buck Boost Converter.SchLib
PCB Design Files/11-7-22/Inductor/CTHFW2918F-100M.PcbLib
PCB Design Files/11-7-22/Resistors/15K/RR01J15KTB.PcbLib
PCB Design Files/11-7-22/Resistors/60.4K/ALSR056K000JE12.PcbLib
PCB Design Files/11-7-22/Resistors/200K/PR01000102003JR500.PcbLib
PCB Design Files/11-7-22/Resistors/400K/CMF60400K00BHBF.PcbLib
PCB Design Files/11-7-22/Stepper Motor Driver/STSPIN220.PcbLib
PCB Design Files/11-7-22/Switching FET/Switching FET.PcbLib
PCB Design Files/11-7-22/Switching FET/Switching FET.SchLib
PCB Design Files/ECEN403_PCB.PcbLib
PCB Design Files/ECEN403_Team_49_Schematic.SchDoc
PCB Design Files/PCB Files_ 12-1-2022_/ECEN 403 PCB Design/1.5nF Capacitor - Copy.PcbLib
PCB Design Files/PCB Files_ 12-1-2022_/ECEN 403 PCB Design/1.5nF Capacitor.PcbLib
PCB Design Files/PCB Files_ 12-1-2022_/ECEN 403 PCB Design/1.5nF Capacitor/CDV19FF152JO3F.PcbLib
PCB Design Files/PCB Files_ 12-1-2022_/ECEN 403 PCB Design/1k Resistor/1kresistor.PcbLib
PCB Design Files/PCB Files_ 12-1-2022_/ECEN 403 PCB Design/10uF Capacitor/EEU-FR1H100.PcbLib
PCB Design Files/PCB Files_ 12-1-2022_/ECEN 403 PCB Design/15k/RR01J15KTB.PcbLib
PCB Design Files/PCB Files_ 12-1-2022_/ECEN 403 PCB Design/16 Pin Header/16 Pin Real.PcbLib
PCB Design Files/PCB Files_ 12-1-2022_/ECEN 403 PCB Design/22uF Capacitor/MAL203851229E3.PcbLib
PCB Design Files/PCB Files_ 12-1-2022_/ECEN 403 PCB Design/60.4k/MRS2500C6042FCT00.PcbLib
PCB Design Files/PCB Files_ 12-1-2022_/ECEN 403 PCB Design/200k/PR01000102003JR500.PcbLib
PCB Design Files/PCB Files_ 12-1-2022_/ECEN 403 PCB Design/400k/CMF60400K00BHBF.PcbLib
PCB Design Files/PCB Files_ 12-1-2022_/ECEN 403 PCB Design/ALSR056K000JE12.PcbLib
PCB Design Files/PCB Files_ 12-1-2022_/ECEN 403 PCB Design/Buck Boost Converter/Buck_Boost_Converter.PcbLib
PCB Design Files/PCB Files_ 12-1-2022_/ECEN 403 PCB Design/Buck Boost Converter/Buck_Boost_Converter.SchLib
PCB Design Files/PCB Files_ 12-1-2022_/ECEN 403 PCB Design/CDV19FF152JO3F.PcbLib
PCB Design Files/PCB Files_ 12-1-2022_/ECEN 403 PCB Design/CMF60400K00BHBF.PcbLib
PCB Design Files/PCB Files_ 12-1-2022_/ECEN 403 PCB Design/Current Sense Amplifier/MAX49921FATA_VY+.PcbLib
PCB Design Files/PCB Files_ 12-1-2022_/ECEN 403 PCB Design/Current Sense Resistor/SR55L000FE66.PcbLib
PCB Design Files/PCB Files_ 12-1-2022_/ECEN 403 PCB Design/ECEN403_OfficialPCB.PcbDoc
PCB Design Files/PCB Files_ 12-1-2022_/ECEN 403 PCB Design/ECEN403_PCB.PcbLib
PCB Design Files/PCB Files_ 12-1-2022_/ECEN 403 PCB Design/ECEN403_TEAM49.PcbLib
PCB Design Files/PCB Files_ 12-1-2022_/ECEN 403 PCB Design/ECEN403_Team_49_Schematic.SchDoc
PCB Design Files/PCB Files_ 12-1-2022_/ECEN 403 PCB Design/Inductor/CTHFW2918F-100M.PcbLib
PCB Design Files/PCB Files_ 12-1-2022_/ECEN 403 PCB Design/LED/LED.PcbLib
PCB Design Files/PCB Files_ 12-1-2022_/ECEN 403 PCB Design/LED/LED.SchLib
PCB Design Files/PCB Files_ 12-1-2022_/ECEN 403 PCB Design/MAX49921FATA_VY+.PcbLib
PCB Design Files/PCB Files_ 12-1-2022_/ECEN 403 PCB Design/Motor Driver/Motor Driver.PcbLib
PCB Design Files/PCB Files_ 12-1-2022_/ECEN 403 PCB Design/MRS2500C6042FCT00.PcbLib
PCB Design Files/PCB Files_ 12-1-2022_/ECEN 403 PCB Design/PCB1.PcbDoc
PCB Design Files/PCB Files_ 12-1-2022_/ECEN 403 PCB Design/PR01000102003JR500.PcbLib
PCB Design Files/PCB Files_ 12-1-2022_/ECEN 403 PCB Design/RR01J15KTB.PcbLib
PCB Design Files/PCB Files_ 12-1-2022_/ECEN 403 PCB Design/Schematic/Schematic.PrjPcb
PCB Design Files/PCB Files_ 12-1-2022_/ECEN 403 PCB Design/Schematic_Library_1.SchLib
PCB Design Files/PCB Files_ 12-1-2022_/ECEN 403 PCB Design/SR55L000FE66.PcbLib
PCB Design Files/PCB Files_ 12-1-2022_/ECEN 403 PCB Design/Wire To Board/Wire to board.PcbLib
PCB Design Files/Schematic_Library_1.SchLib
