tamu-edu-students/ECEN403_Team49/(commit log)

2022-12-02 Push_INIT
    First push to repo; All Google Drive files/folders included
    [1.5nF Capacitor - Copy.PcbLib, 1.5nF Capacitor.PcbLib, 16 Pin Real.PcbLib, 1kresistor.PcbLib, ADC converter.PcbLib, ADC converter.SchLib, ALSR056K000JE12.PcbLib, Buck Boost Converter.PcbLib]
2023-01-24 directory name change
    foo bar
    [dummy1.csv, dummy2.csv]
2023-02-07 Added IO test to GUI section
    [dummy3.csv]
2023-02-20 Update files in new GUI
    [dummy1.csv, dummy2.csv, dummy3.csv]
2023-03-06 Added MotorTest, changed SimpleTests
2023-03-06 Update MotorTest
2023-03-06 Added Alt MotorSteps
2023-03-07 Changed MotorTest2 MotorTest2Alt
2023-03-20 Updated MotorTest2Alt
2023-03-27 Added Final Integration
    [dummy3.csv, dummyLong.csv]
2023-03-29 Updated full Integration (at home)
    [dummyLong.csv]
2023-04-03 added new anim, updated IntegrationFull
    [dummyLong.csv]
2023-04-03 updated IntegrationFull with graphs and long-term
    [dummyLong.csv]
2023-04-10 updated GUI in IntegrationFull.py
    [dummyLong.csv]
2023-04-24 Pres_Push
    Updated all presentations and papers and etc.
    [PCB Buck Boost Converter Results.xlsx, Parts Lists.xlsx, exec_valid_excel_finalreport.xlsx]
